Tironzi/SMART-HOME-SYSTEM_Final-Project/REPORT/MẠCH THỰC TẾ.jpg

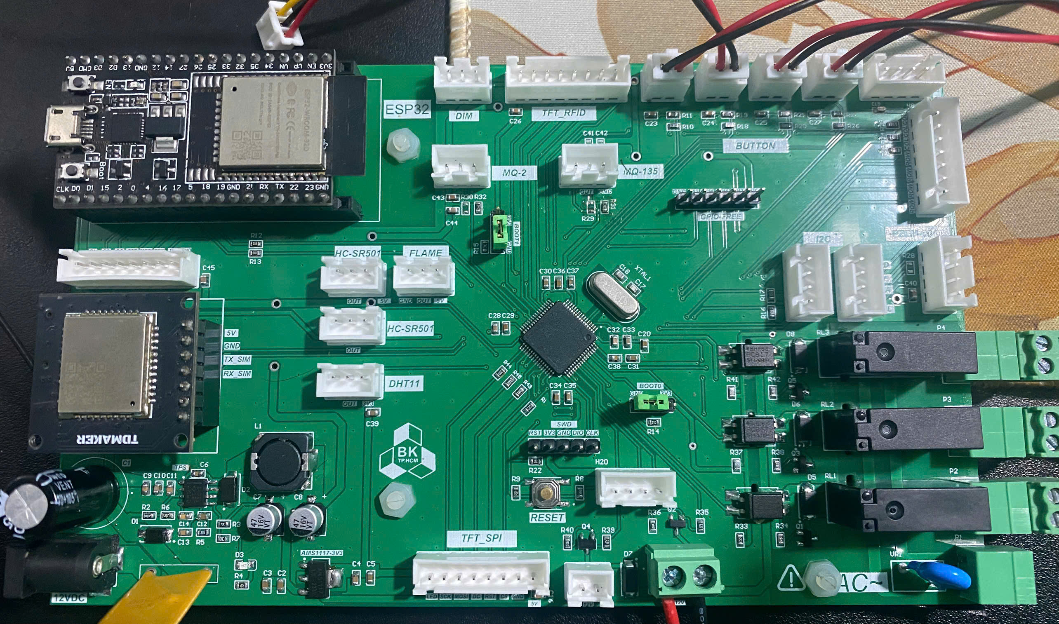
REPORT/MẠCH THỰC TẾ.jpg
