Tironzi/SMART-HOME-SYSTEM_Final-Project/HÌNH ẢNH SẢN PHẨM/SẢN PHẨM-1.jpg

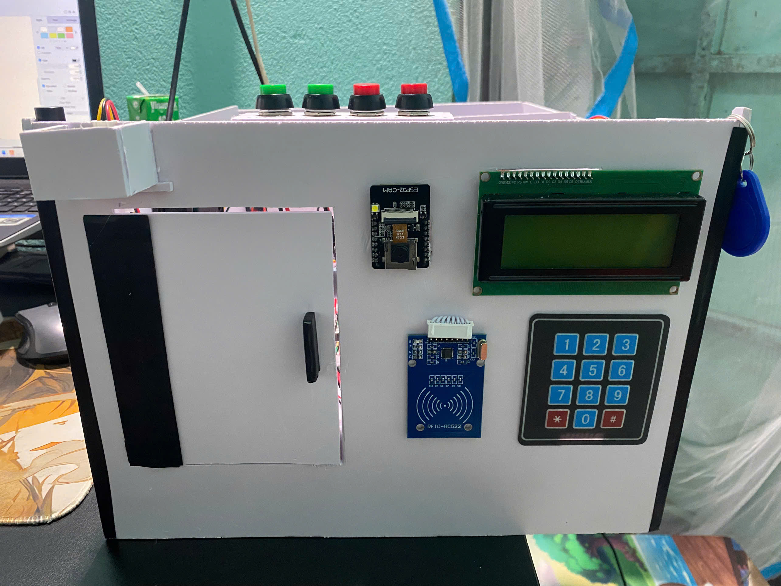
HÌNH ẢNH SẢN PHẨM/SẢN PHẨM-1.jpg
