Tironzi/SMART-HOME-SYSTEM_Final-Project/README.md

LINK WEB DASDBOARD: https://hcmuthomedashboard-leviettrong.vercel.app/

TK: leviettrong

MK: 123456
