Tironzi/SMART-HOME-SYSTEM_Final-Project/HÌNH ẢNH SẢN PHẨM/SẢN PHẨM.jpg

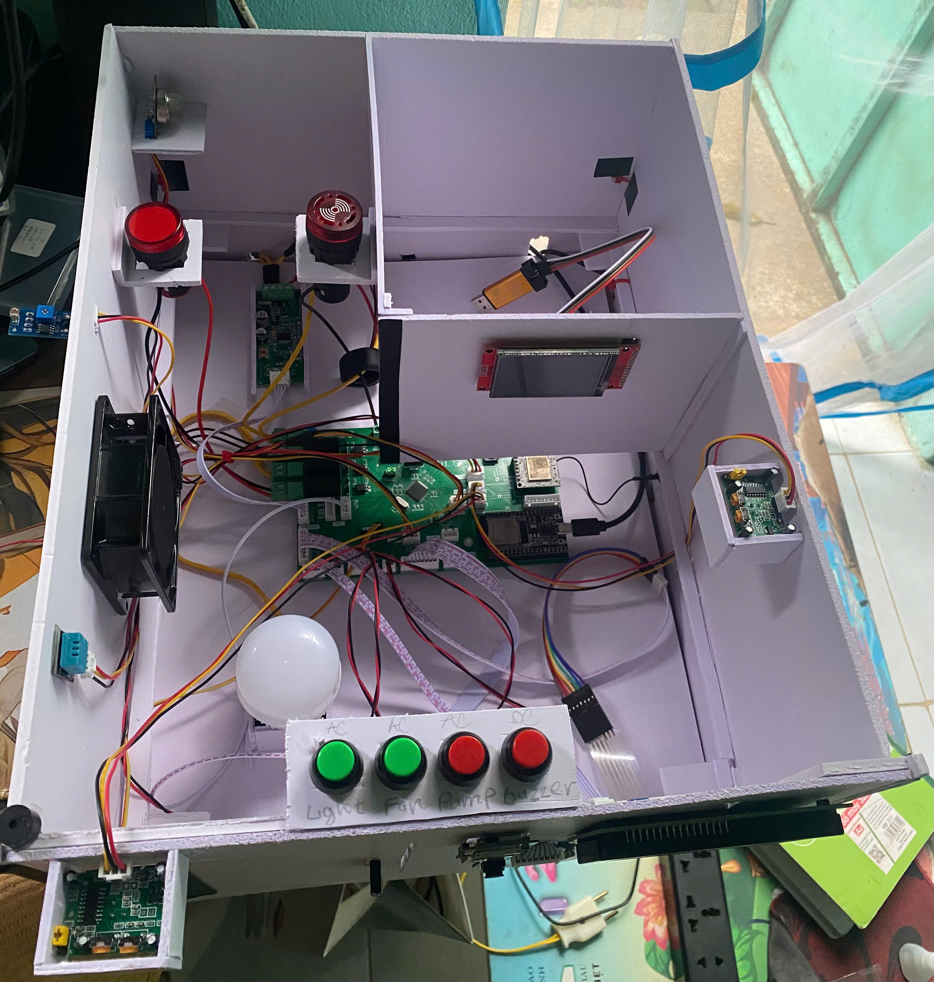
HÌNH ẢNH SẢN PHẨM/SẢN PHẨM.jpg
