Tironzi/SMART-HOME-SYSTEM_Final-Project/2012298_LÊ VIẾT TRỌNG_BÁO CÁO FINAL/Schematic_PCB/BLOCK DIAGRAM.pdf

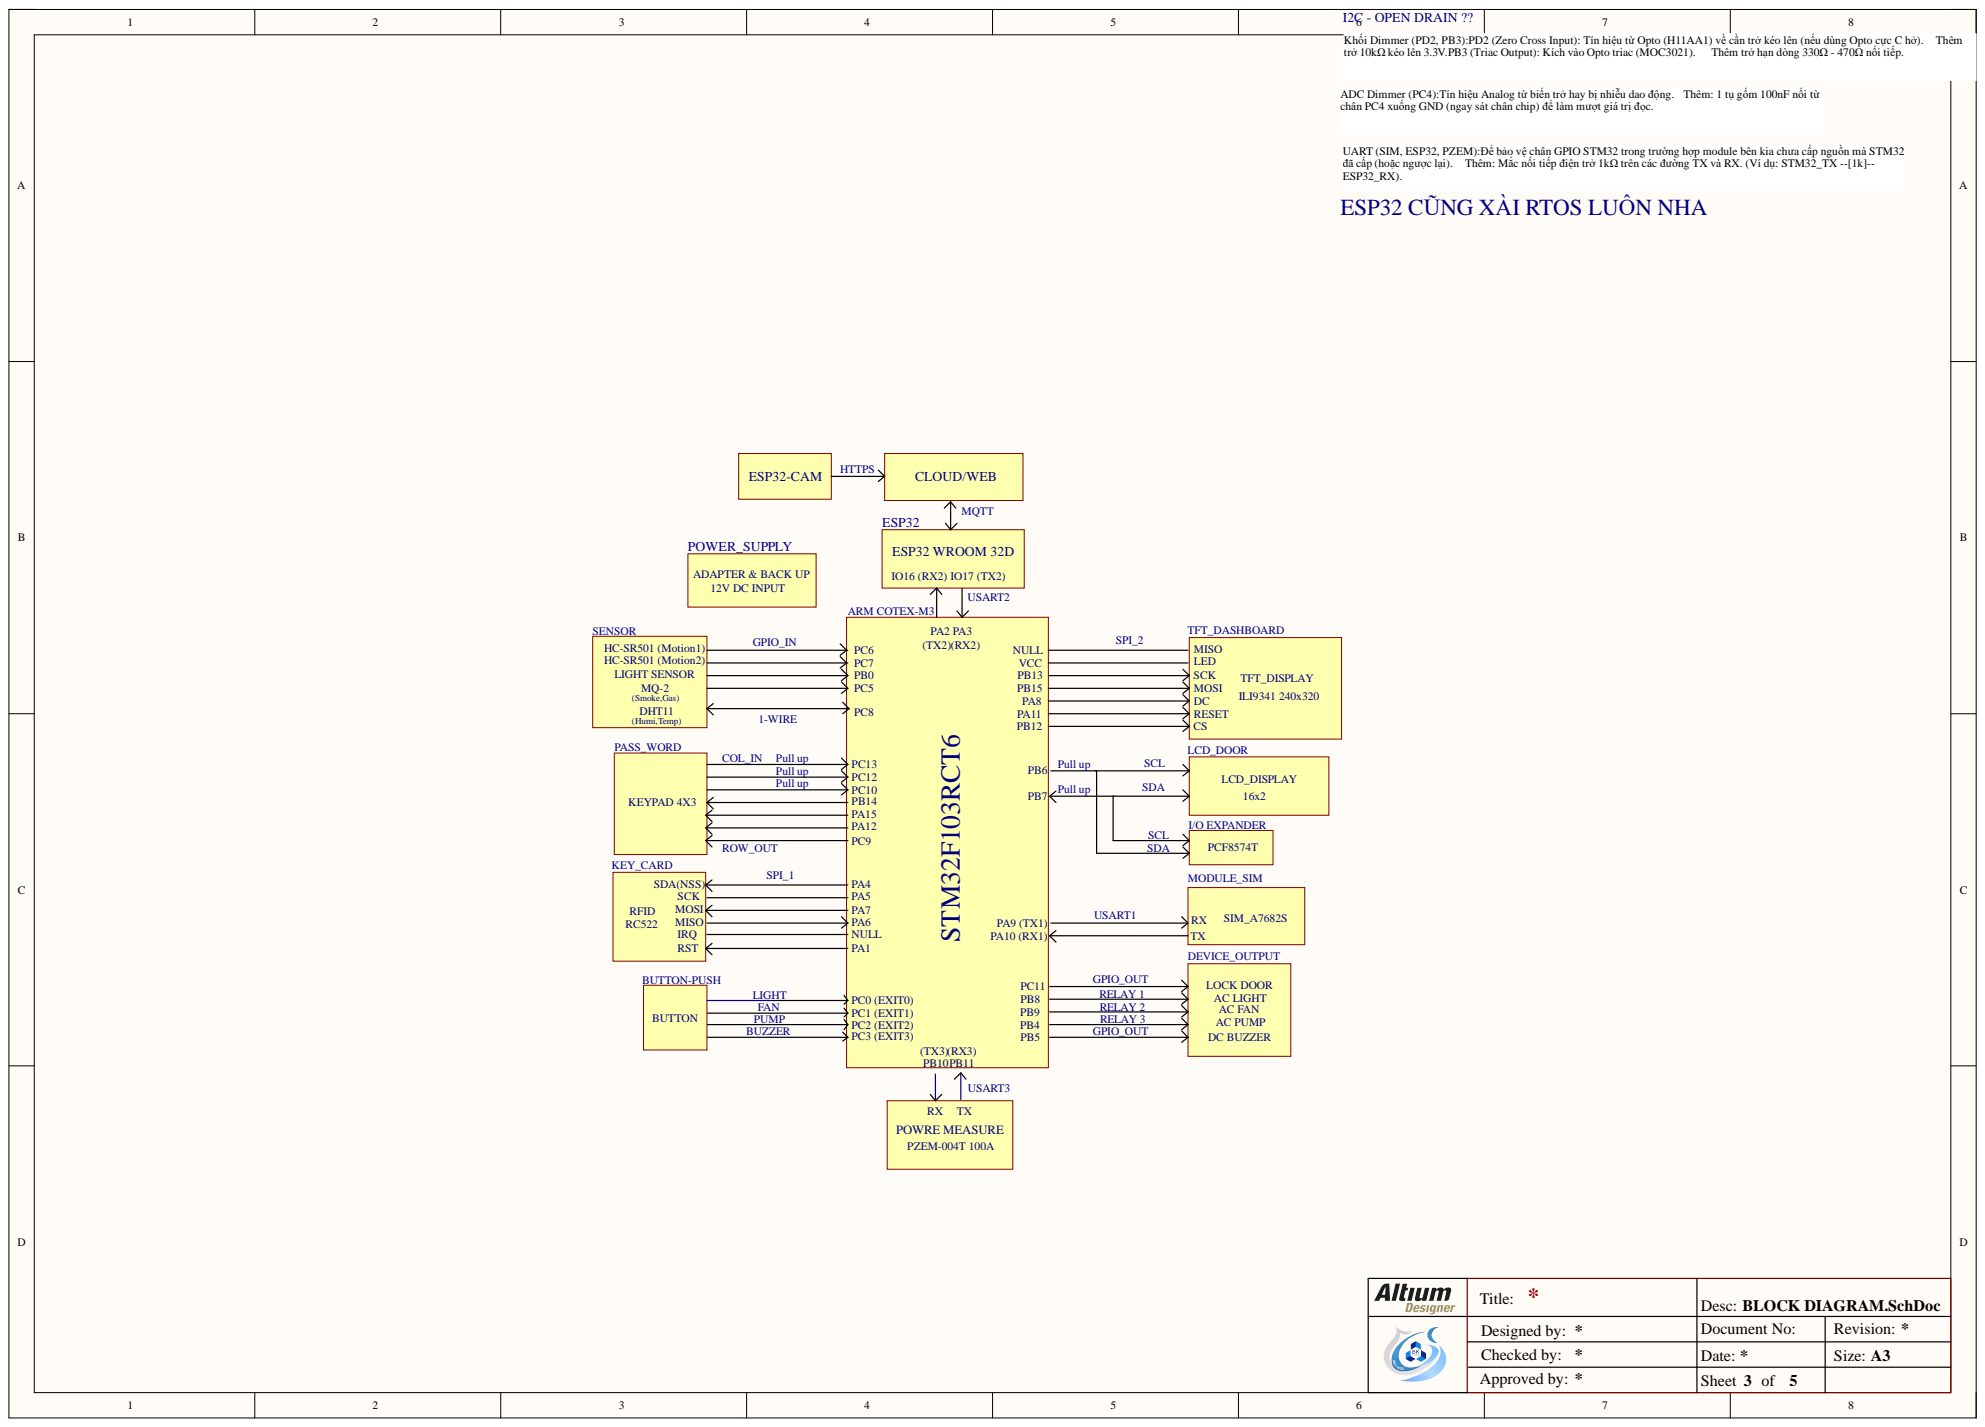
[picture p72: page 1]

I2C - OPEN DRAIN ??
Khối Dimmer (PD2, PB3):PD2 (Zero Cross Input): Tín hiệu từ Opto (H11AA1) về cần trở kéo lên (nếu dùng Opto cực C hở). Thêm

ADC Dimmer (PC4):Tín hiệu Analog từ biến trở hay bị nhiễu dao động. Thêm: 1 tụ gốm 100nF nối từ
chân PC4 xuống GND (ngay sát chân chip) để làm mượt giá trị đọc.

UART (SIM, ESP32, PZEM):Để bảo vệ chân GPIO STM32 trong trường hợp module bên kia chưa cấp nguồn mà STM32
đã cấp (hoặc ngược lại). Thêm: Mắc nối tiếp điện trở 1kΩ trên các đường TX và RX. (Ví dụ: STM32_TX --[1k]--
ESP32_RX).
ESP32 CŨNG XÀI RTOS LUÔN NHA

LOCK DOOR
AC LIGHT AC FAN

PUMP | RELAY 3
BUZZER | GPIO_OUT

Title: * | Desc: BLOCK DIAGRAM.SchDoc

Designed by: * | Document No: | Revision: *
Checked by: * | Date: * | Size: A3
Approved by: * | Sheet 3 5 of
