Tironzi/SMART-HOME-SYSTEM_Final-Project/2012298_LÊ VIẾT TRỌNG_BÁO CÁO FINAL/Schematic_PCB/DEVICE.pdf

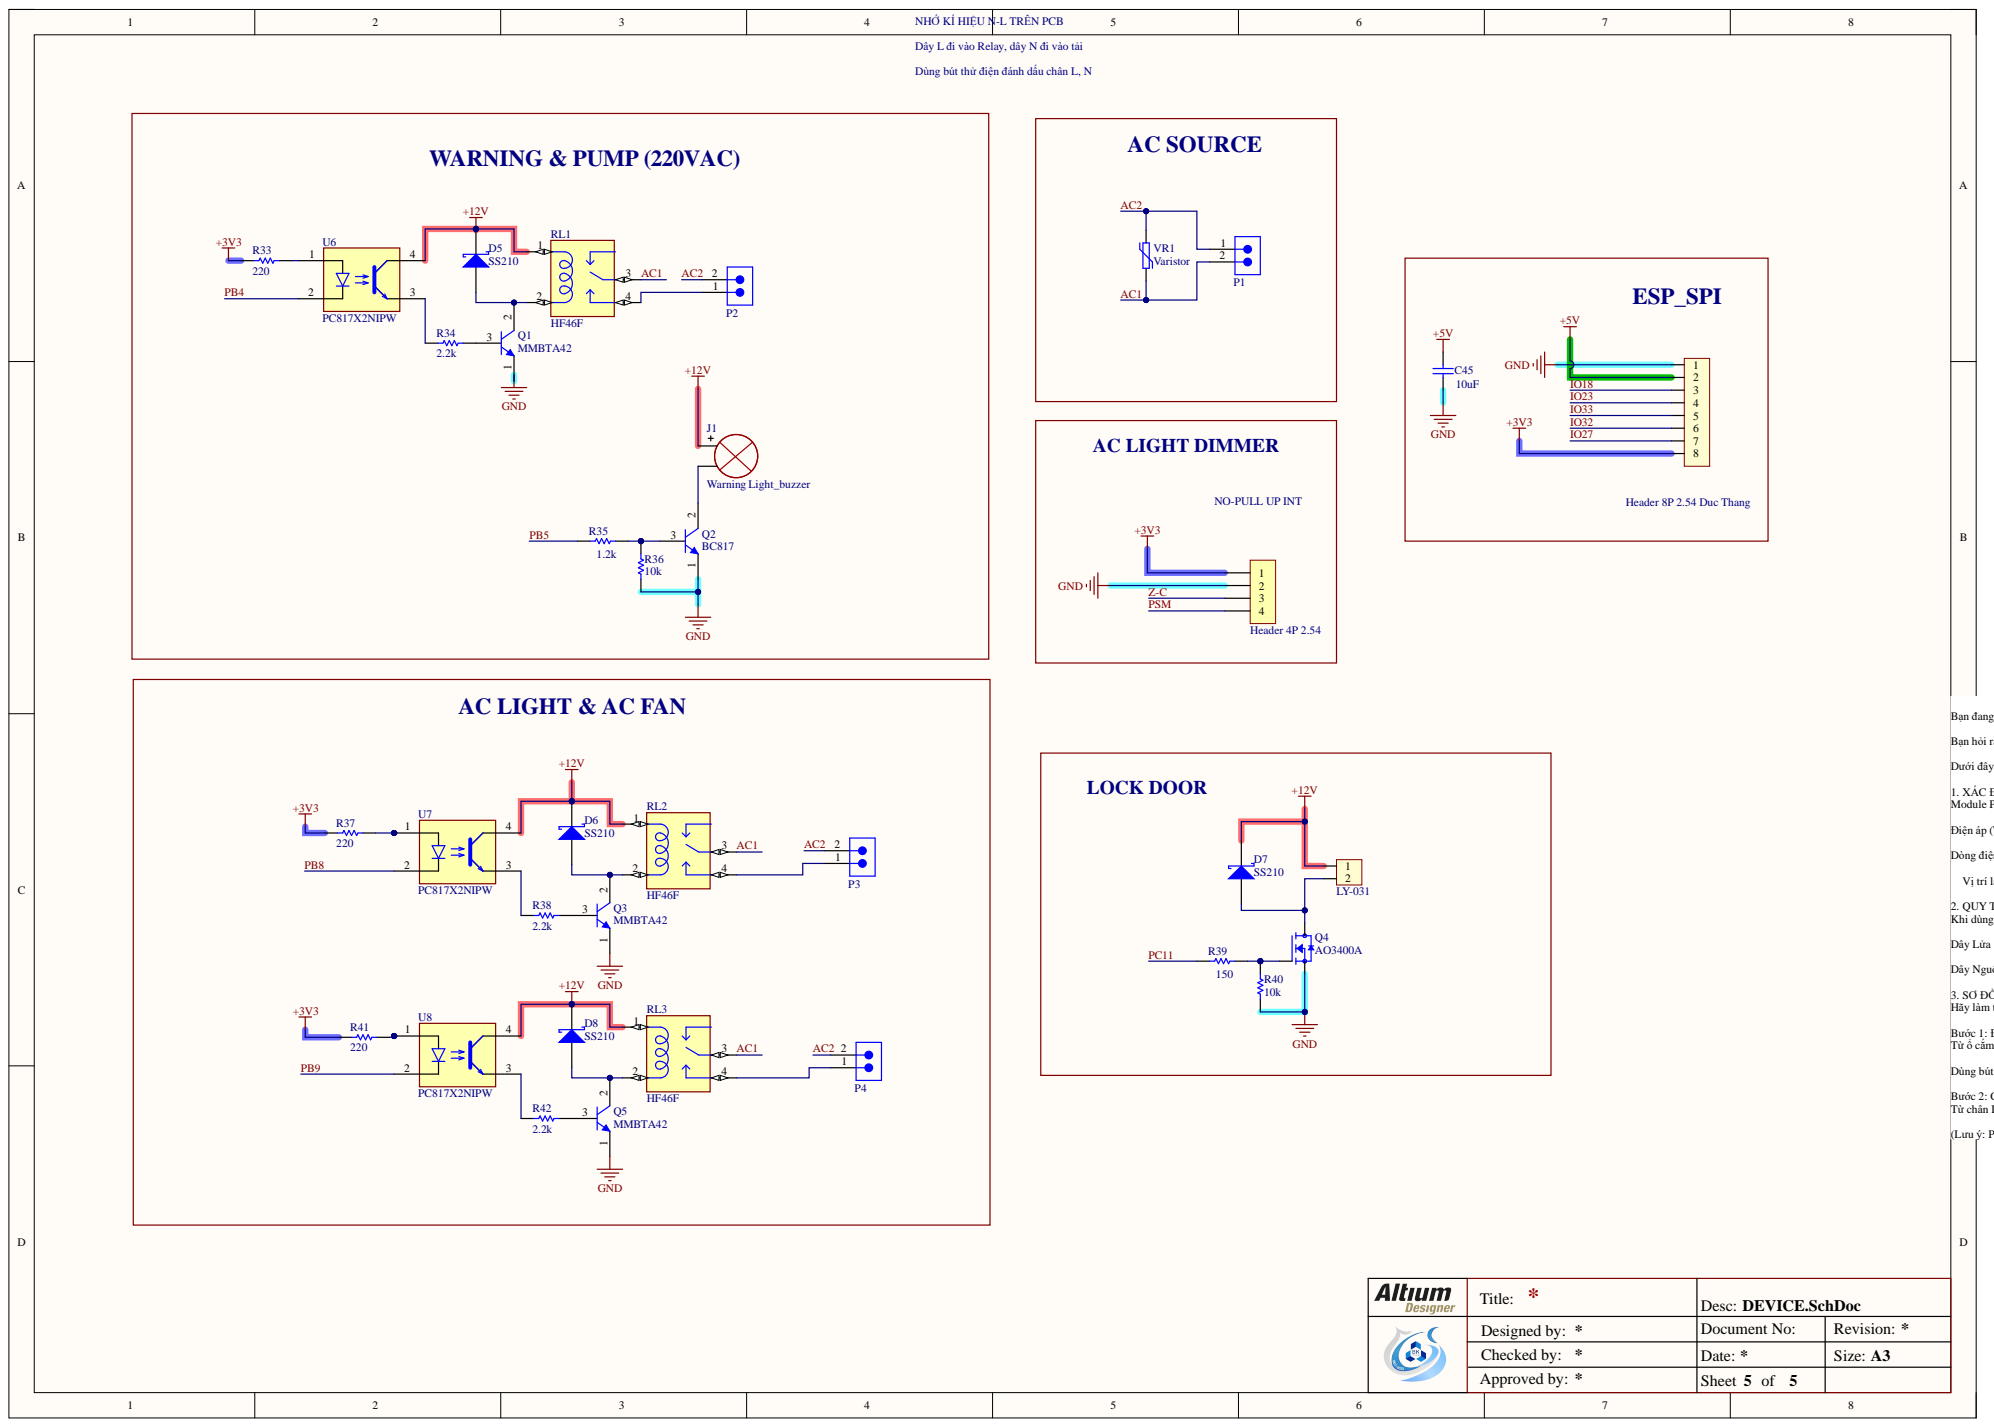
[picture p73: page 1]

Approved by: Title: Designed by: * | Document No: | Revision: *

* | Desc : DEVICE.SchDoc

Checked by: ** | Date : * of | Siz e : A3

She e t 5 5
