Tironzi/SMART-HOME-SYSTEM_Final-Project/PCB/SMART_HOME_FINAL_PCB/POWER SUPPLY.pdf

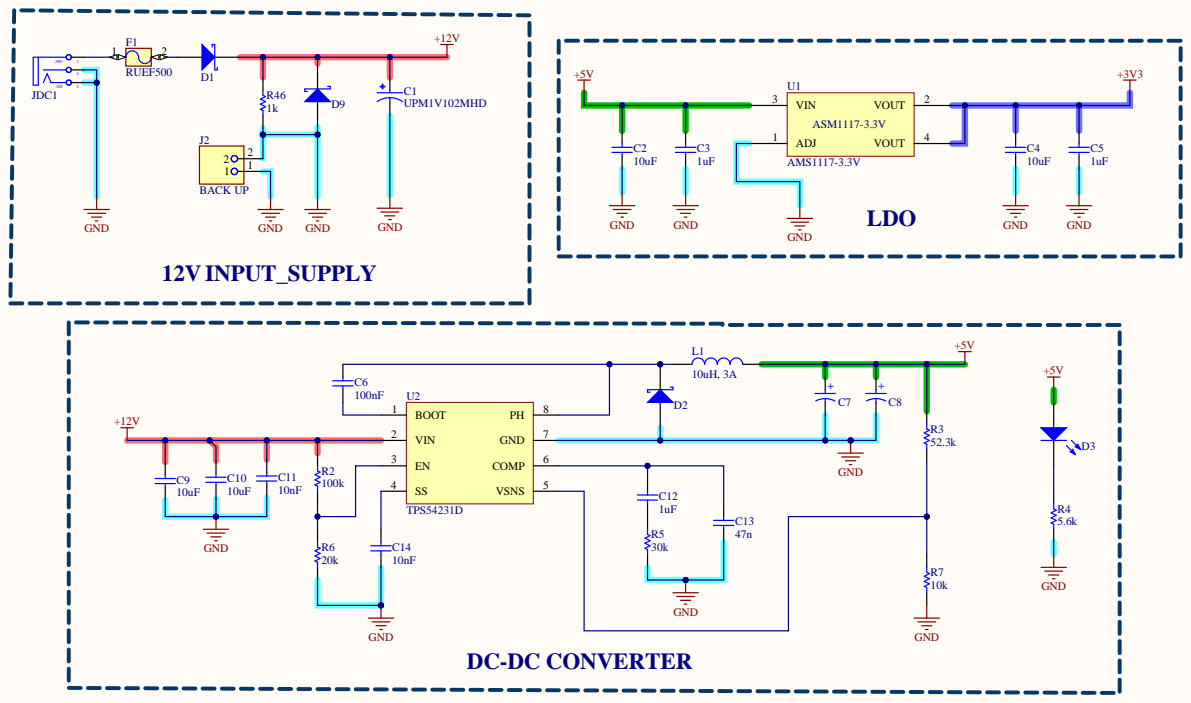
[picture p74: page 1]

Approved by: Title: Designed by: * | Document No: | Revision: *

* | Desc : POWER SUPPL Y.SchDoc

Checked by: ** | Date : * of | Siz e : A3

She e t 2 5
