Tironzi/SMART-HOME-SYSTEM_Final-Project/2012298_LÊ VIẾT TRỌNG_BÁO CÁO FINAL/Schematic_PCB/MCU.pdf

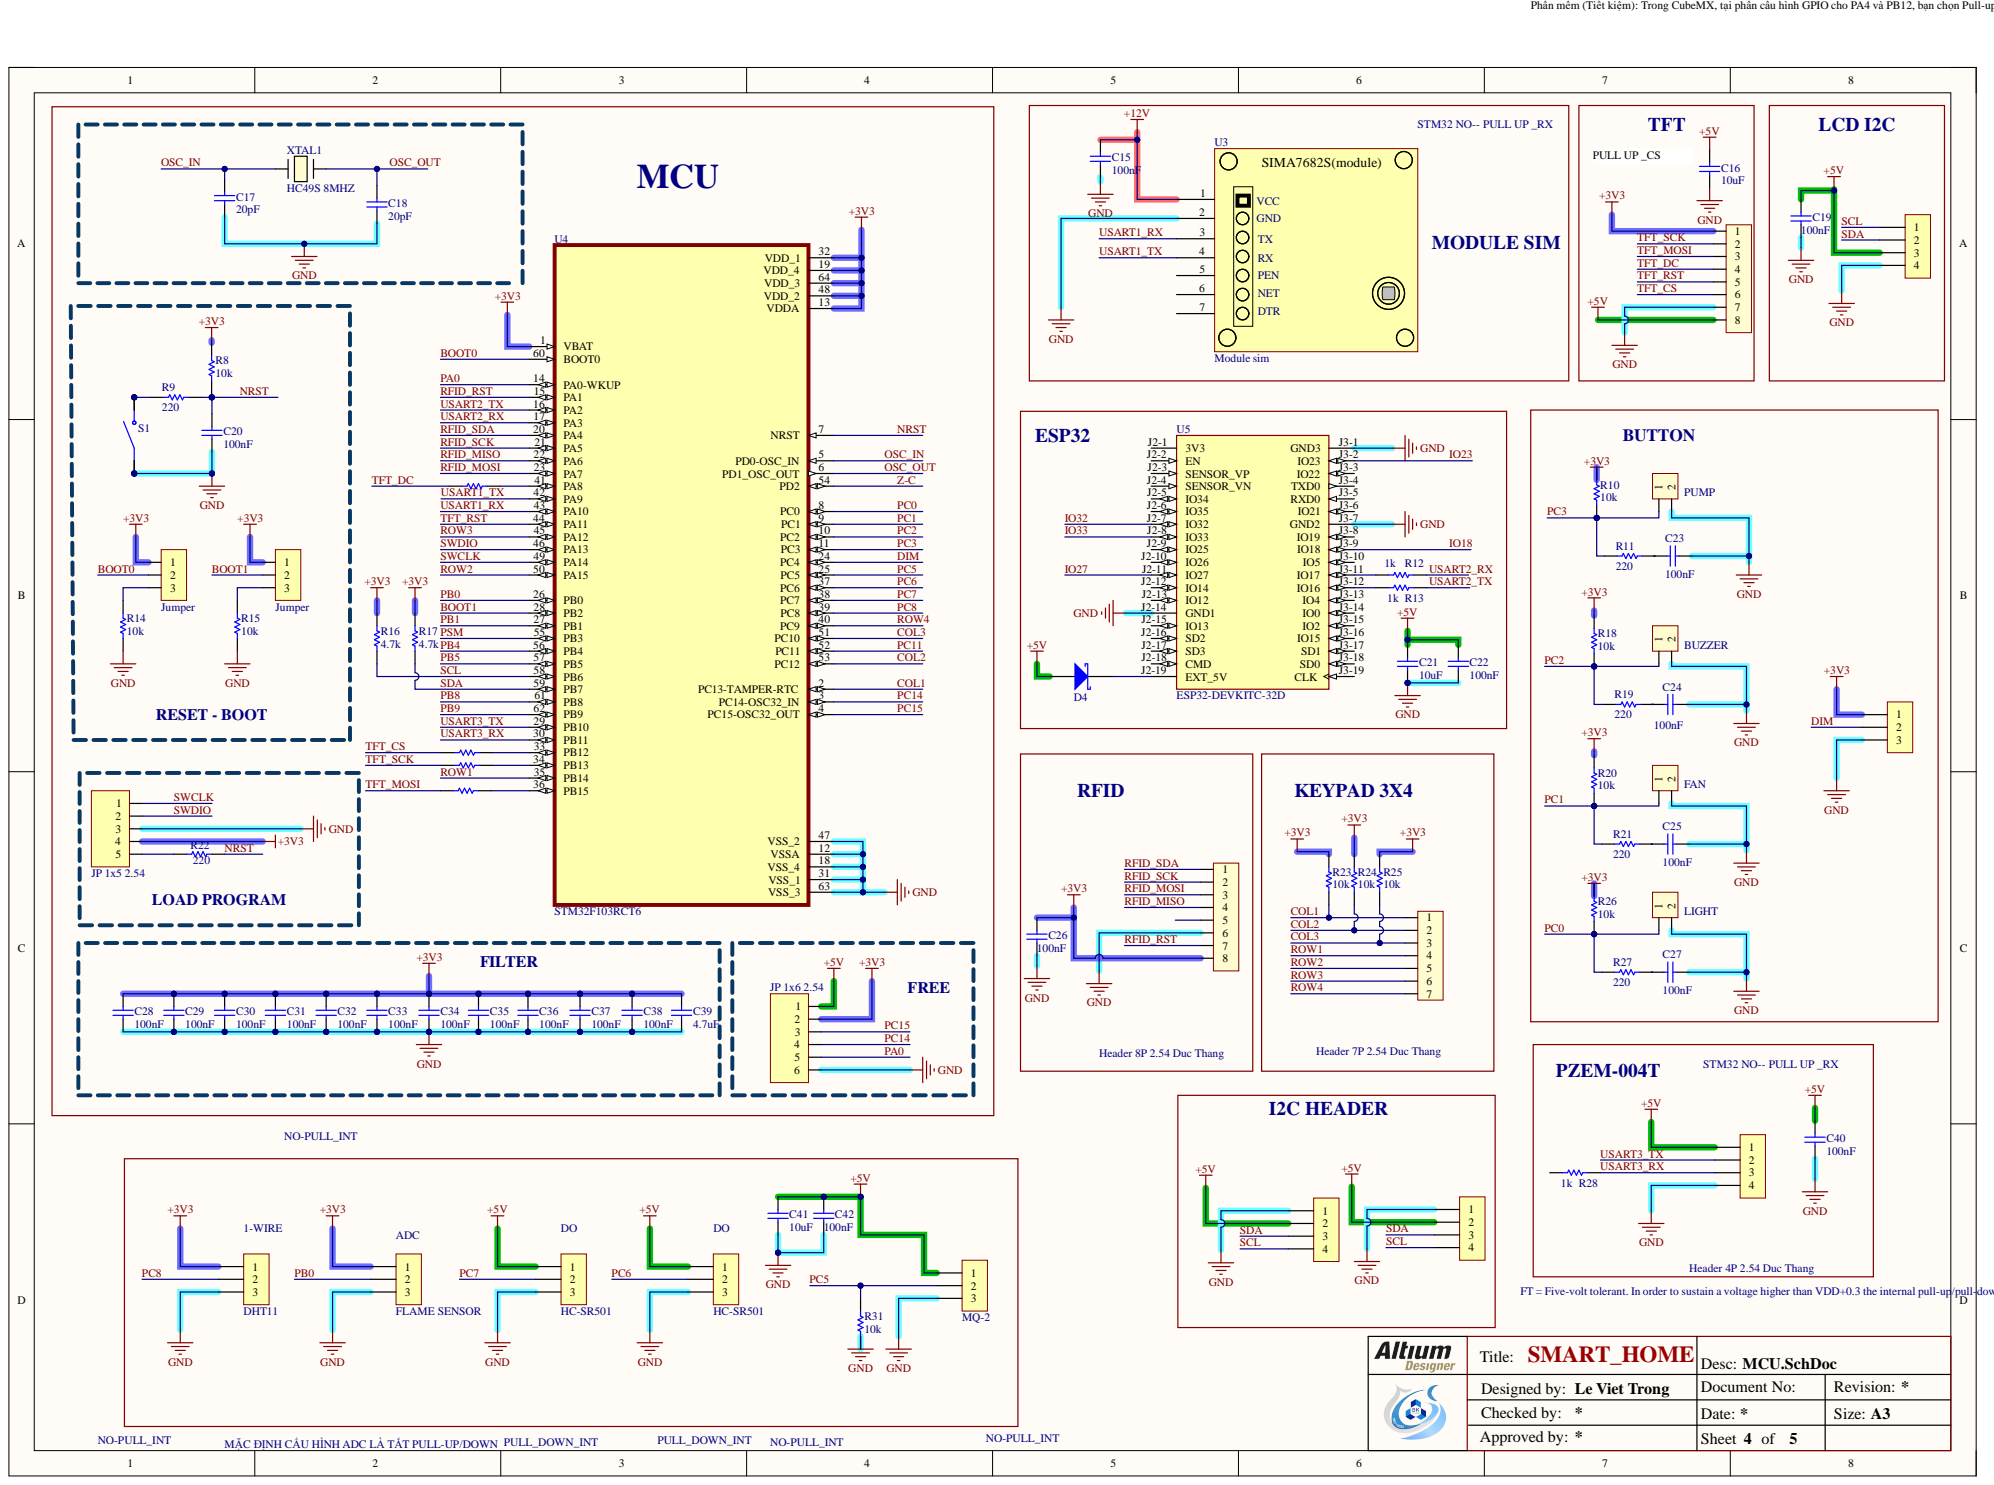
[picture p77: page 1]

Approved by: Title: Designed by: Viet Le Tron g | Document No: | Revision: *

Checked by: ** | Date : * of | Siz e : A3

She e t 4 5
