Tironzi/SMART-HOME-SYSTEM_Final-Project/2012298_LÊ VIẾT TRỌNG_BÁO CÁO FINAL/Schematic_PCB/POWER DIAGRAM.pdf

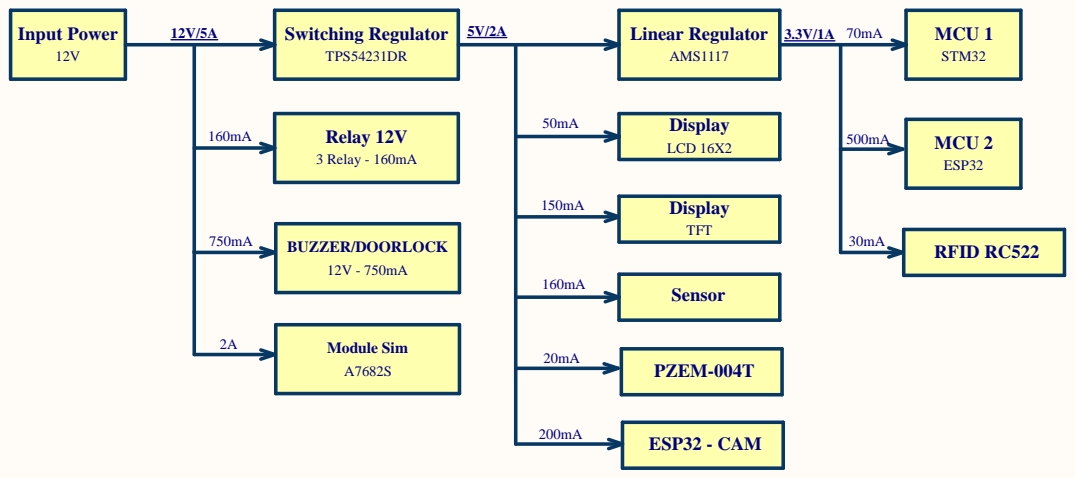
[picture p78: page 1]
