Tironzi/SMART-HOME-SYSTEM_Final-Project/(list of files, drawings)

Other design files:
PCB/SMART_HOME_FINAL_PCB/BLOCK DIAGRAM.SchDoc
PCB/SMART_HOME_FINAL_PCB/DEVICE.SchDoc
PCB/SMART_HOME_FINAL_PCB/MCU.SchDoc
PCB/SMART_HOME_FINAL_PCB/POWER DIAGRAM.SchDoc
PCB/SMART_HOME_FINAL_PCB/POWER SUPPLY.SchDoc
PCB/SMART_HOME_FINAL_PCB/SMART_HOME_FINAL.PrjPcb
